adihack/esp32-swd/docs/images/board_3d_bottom.png

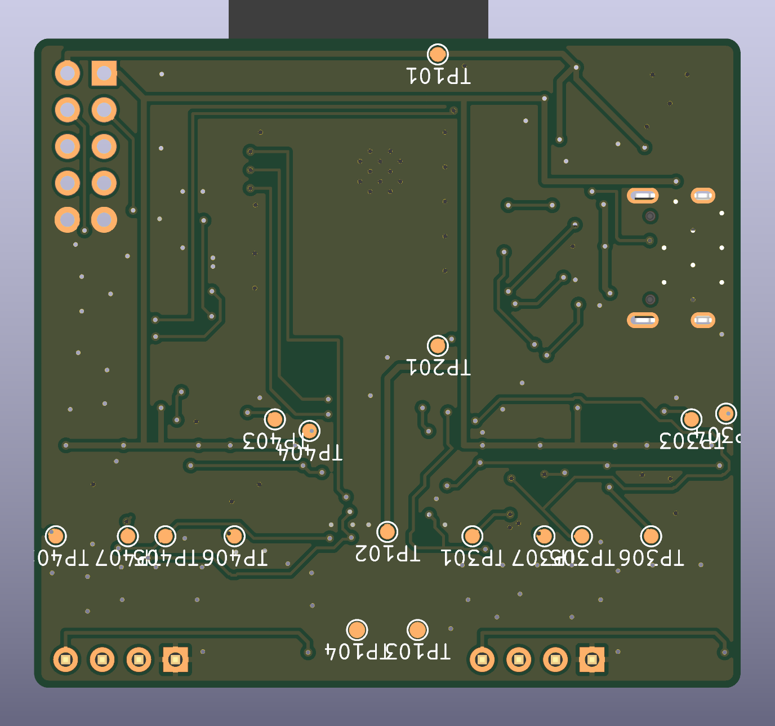
docs/images/board_3d_bottom.png
