adihack/esp32-swd/docs/images/board_3d_top.png

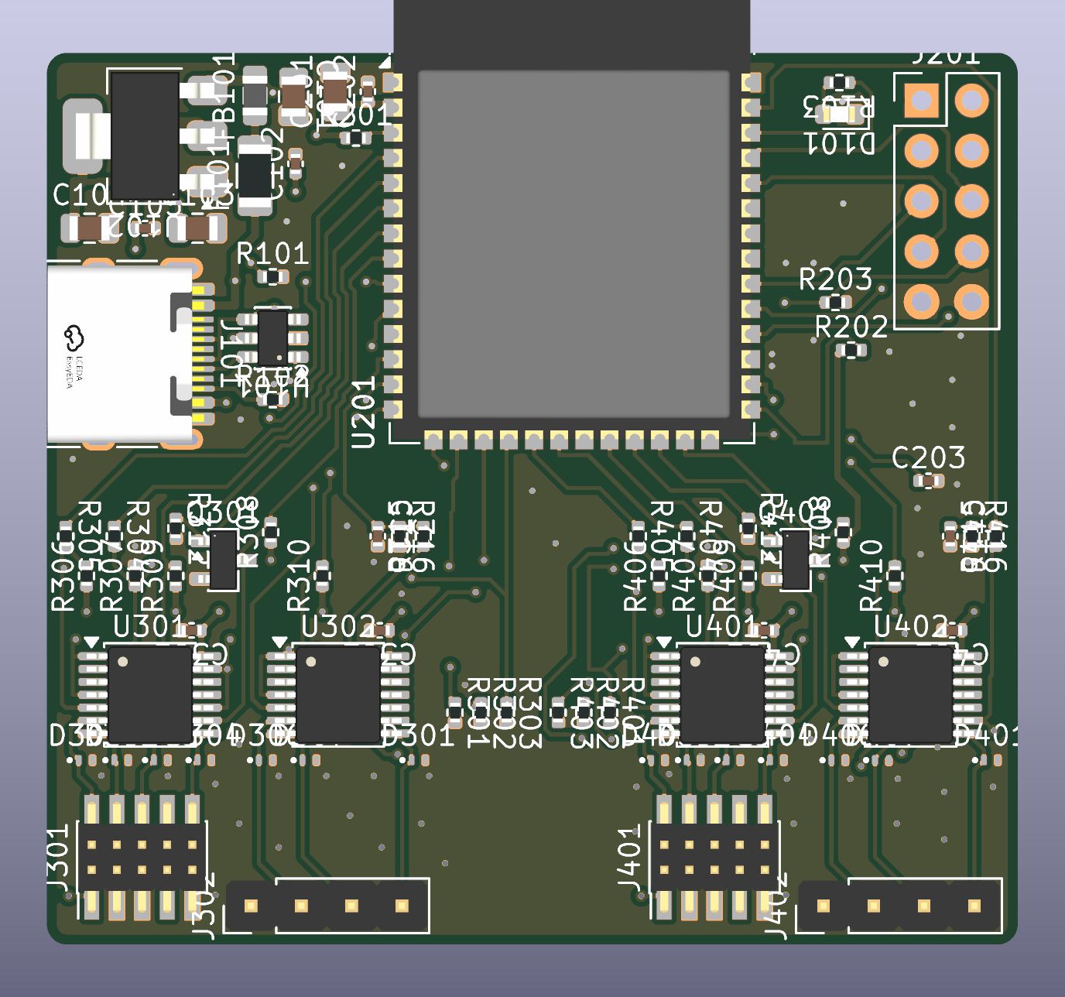
docs/images/board_3d_top.png
