adihack/esp32-swd/hardware/rev5/production/jlcpcb_2026-10-23_r5/BOM-dual_swd_flasher_JLCPCB.csv

Comment | Designator | Footprint | LCSC Part #
10uF | C101,C103,C201 | Capacitor_SMD:C_0805_2012Metric | C15850
100nF | C102,C105,C202,C301,C302,C316,C401,C402,C416 | Capacitor_SMD:C_0402_1005Metric | C1525
22uF | C104 | Capacitor_SMD:C_0805_2012Metric | C45783
1uF | C203 | Capacitor_SMD:C_0402_1005Metric | C52923
White | D101 | LED_SMD:LED_0603_1608Metric | C2290
ESD321DPYR | D301,D302,D303,D304,D305,D306,D307,D401,D402,D403,D404,D405,D406,D407 | Package_SON:Texas_DPY0002A_0.6x1mm_P0.65mm | C2868952
0R | F101 | Fuse:Fuse_1206_3216Metric | C17888
100R@100MHz | FB101 | Inductor_SMD:L_0805_2012Metric | C1015
USB_C_Receptacle_USB2.0_16P | J101 | Connector_USB:USB_C_Receptacle_HRO_TYPE-C-31-M-12 | C165948
SWD_A/SWD_B | J301,J401 | Connector_PinHeader_1.27mm:PinHeader_2x05_P1.27mm_Vertical_SMD | C3975188
2N7002 | Q301,Q401 | Package_TO_SOT_SMD:SOT-23 | C8545
5.1k | R101,R102 | Resistor_SMD:R_0402_1005Metric | C25905
1k | R103 | Resistor_SMD:R_0402_1005Metric | C11702
10k | R201,R202,R203 | Resistor_SMD:R_0402_1005Metric | C25744
100k | R301,R302,R303,R306,R307,R308,R309,R310,R312,R315,R316,R401,R402,R403,R406,R407,R408,R409,R410,R412,R415,R416 | Resistor_SMD:R_0402_1005Metric | C25741
33R | R304,R305,R404,R405 | Resistor_SMD:R_0402_1005Metric | C25105
SRV05-4 | U101 | Package_TO_SOT_SMD:SOT-23-6 | C7420376
AMS1117-3.3 | U102 | Package_TO_SOT_SMD:SOT-223-3_TabPin2 | C6186
TMUX1511PW | U301,U302,U401,U402 | Package_SO:TSSOP-14_4.4x5mm_P0.65mm | C2866750
