adihack/esp32-swd/hardware/rev5/schematic_rev5.pdf

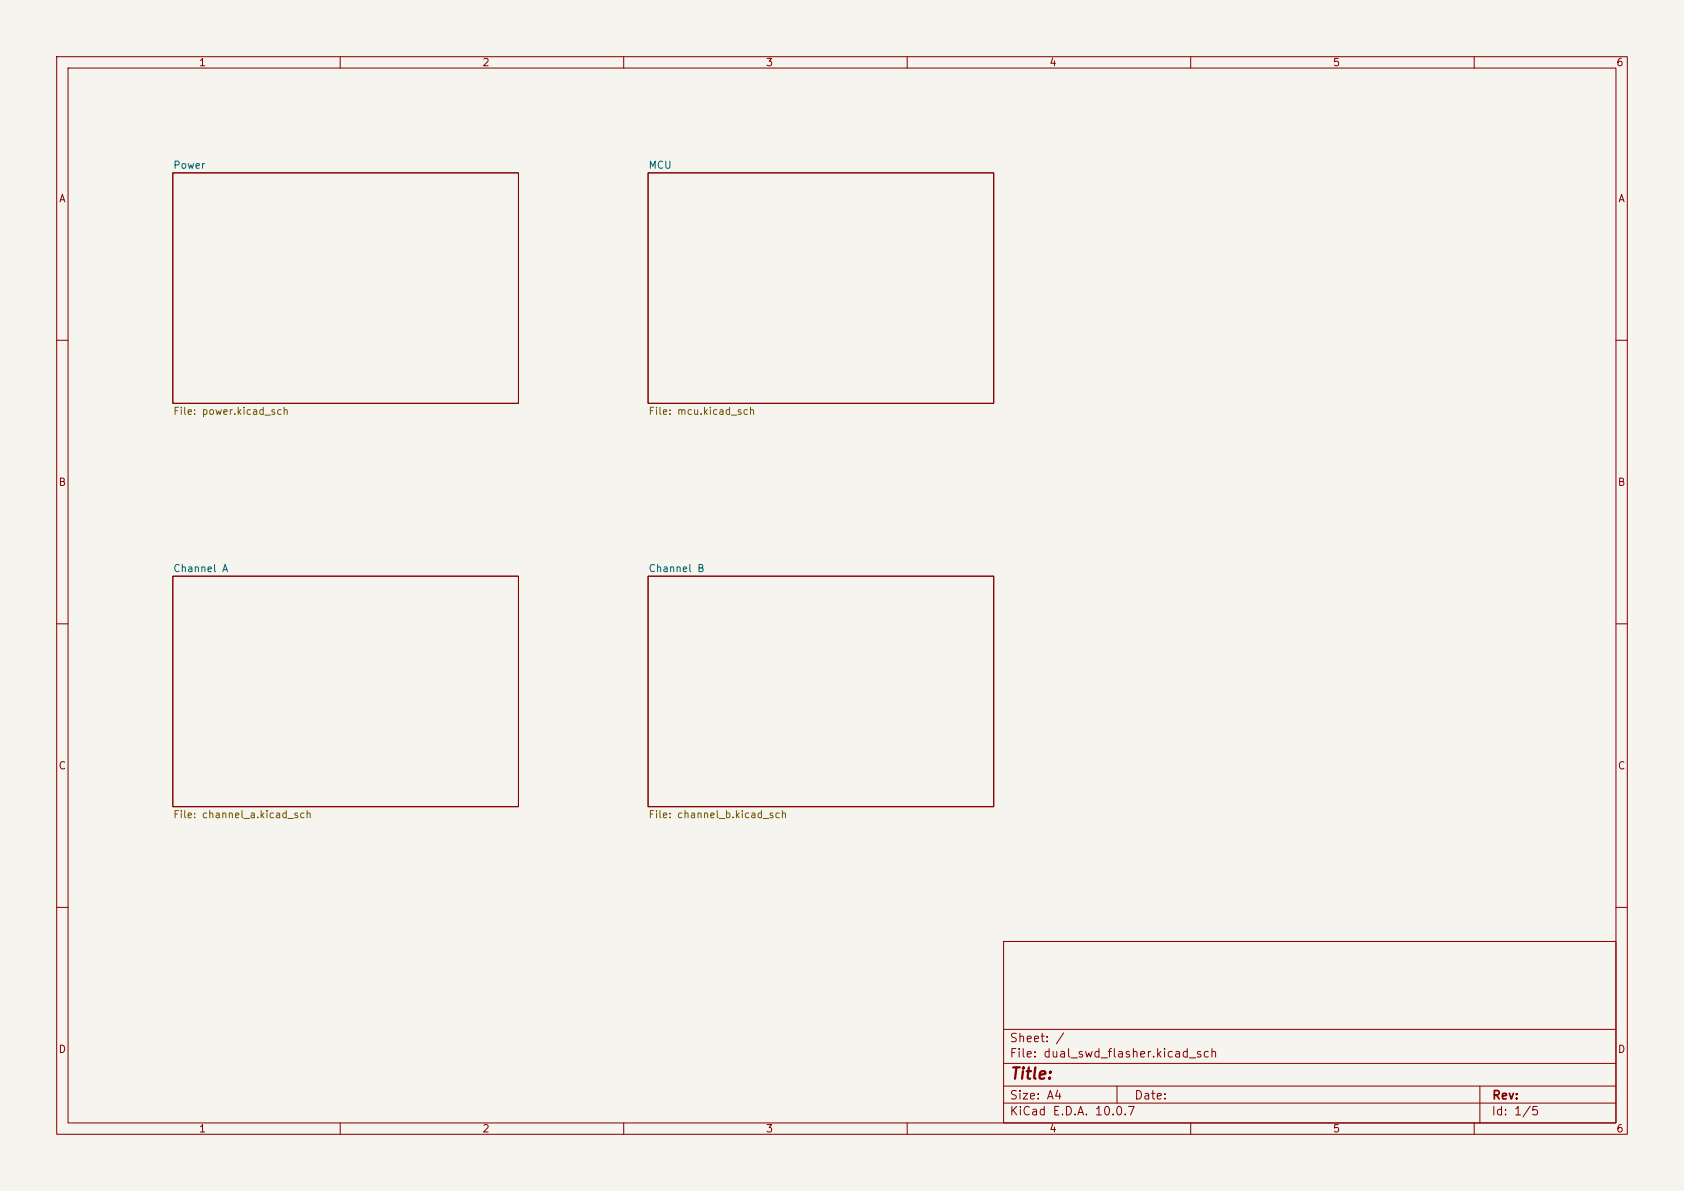
[picture p4: page 1]

Size: A4 | Rev:
KiCad E.D.A. 10.0.7 | Id: 1/5

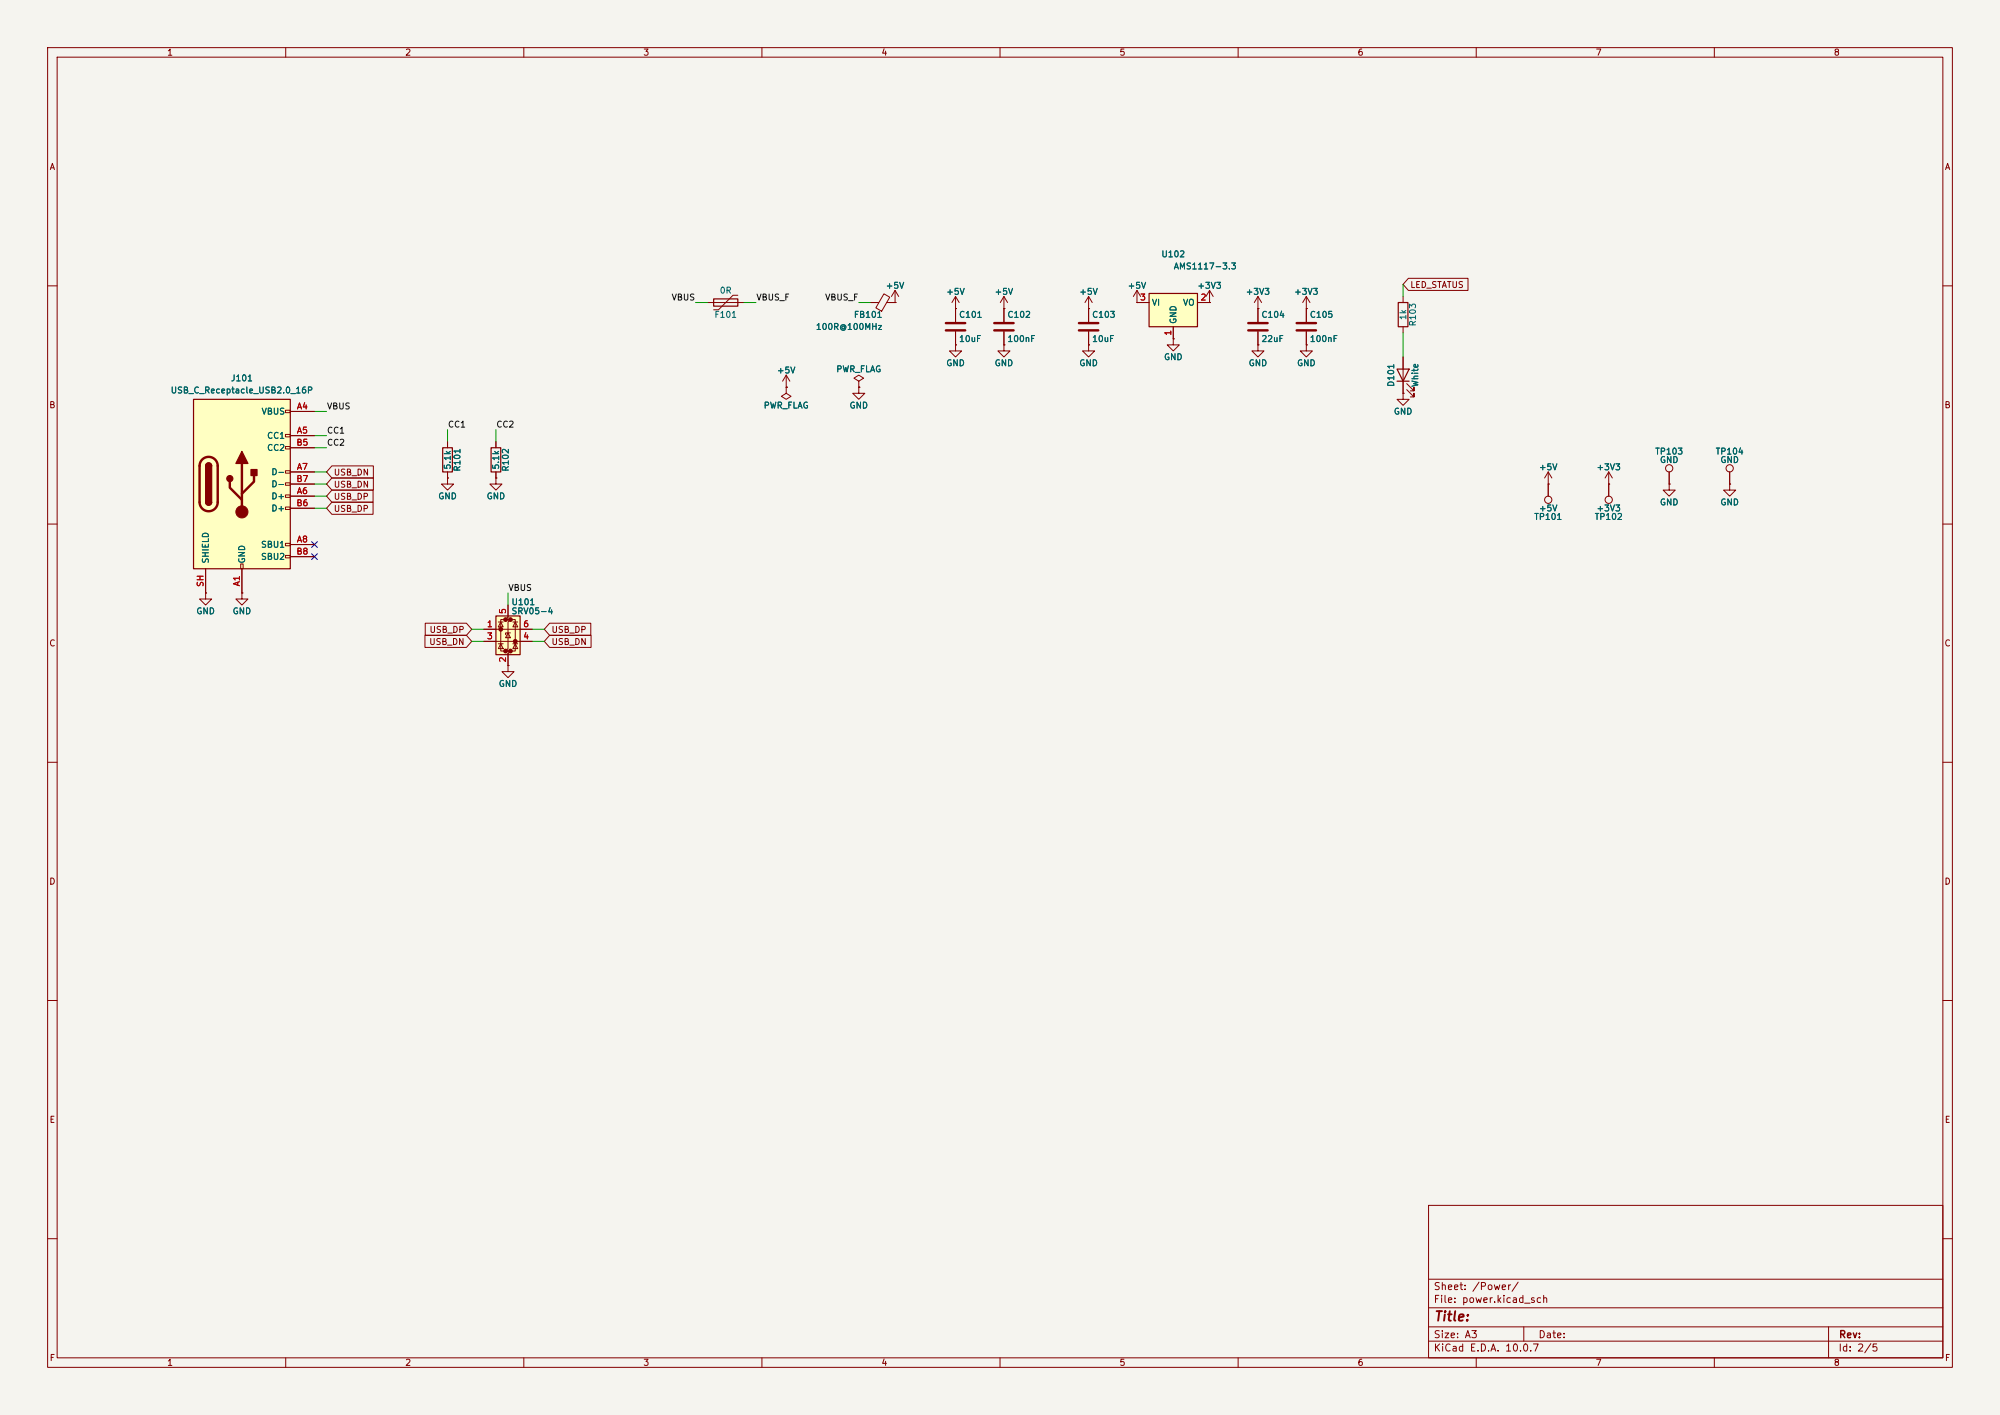
[picture p5: page 2]

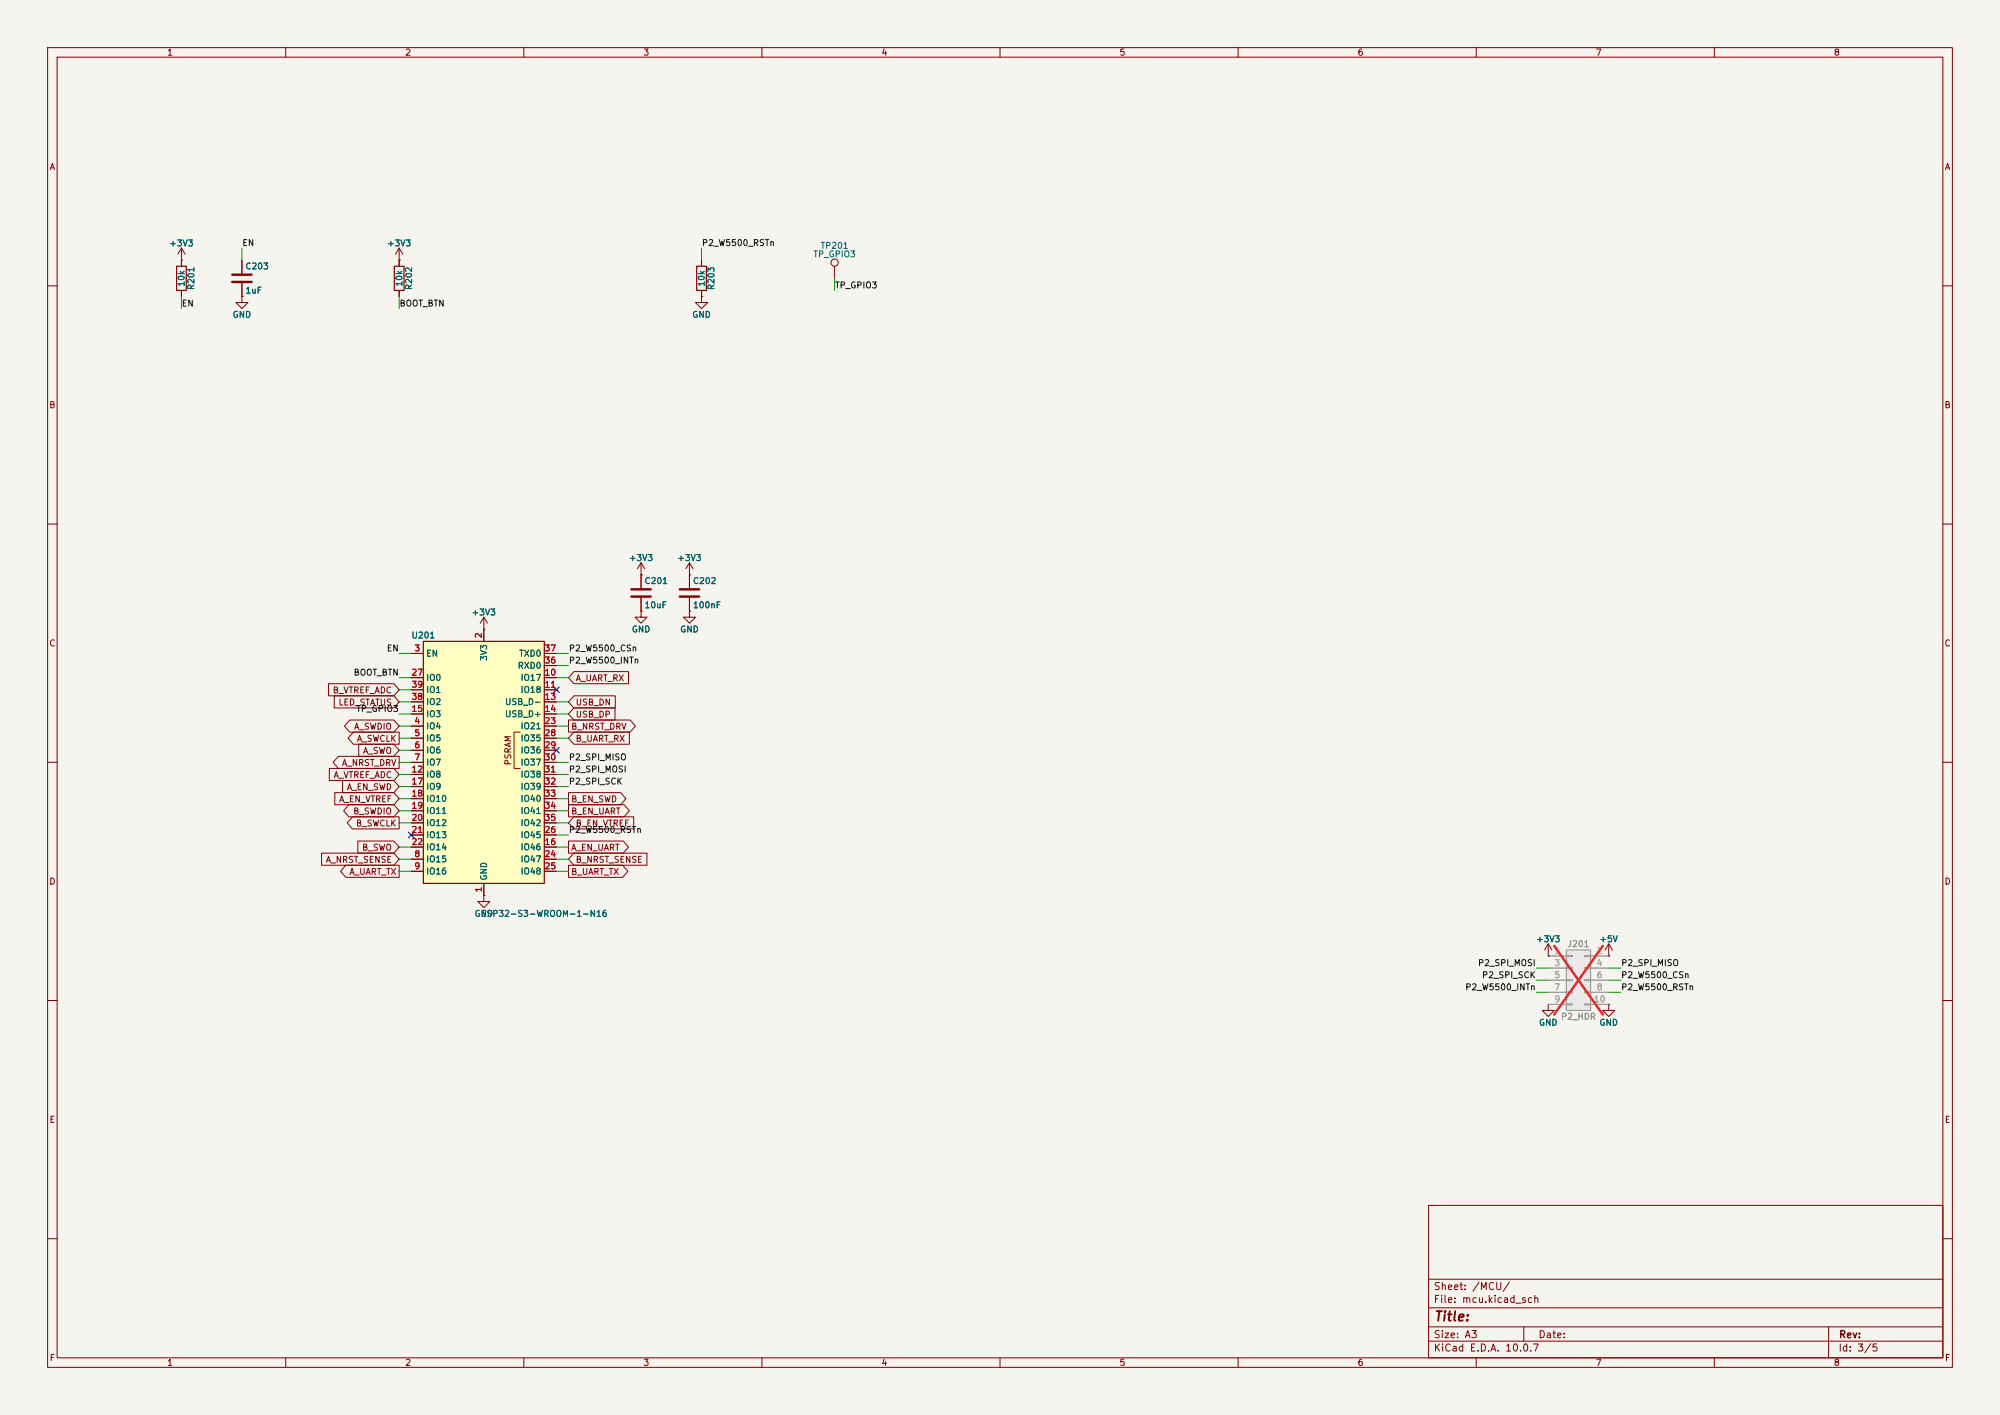
[picture p6: page 3]

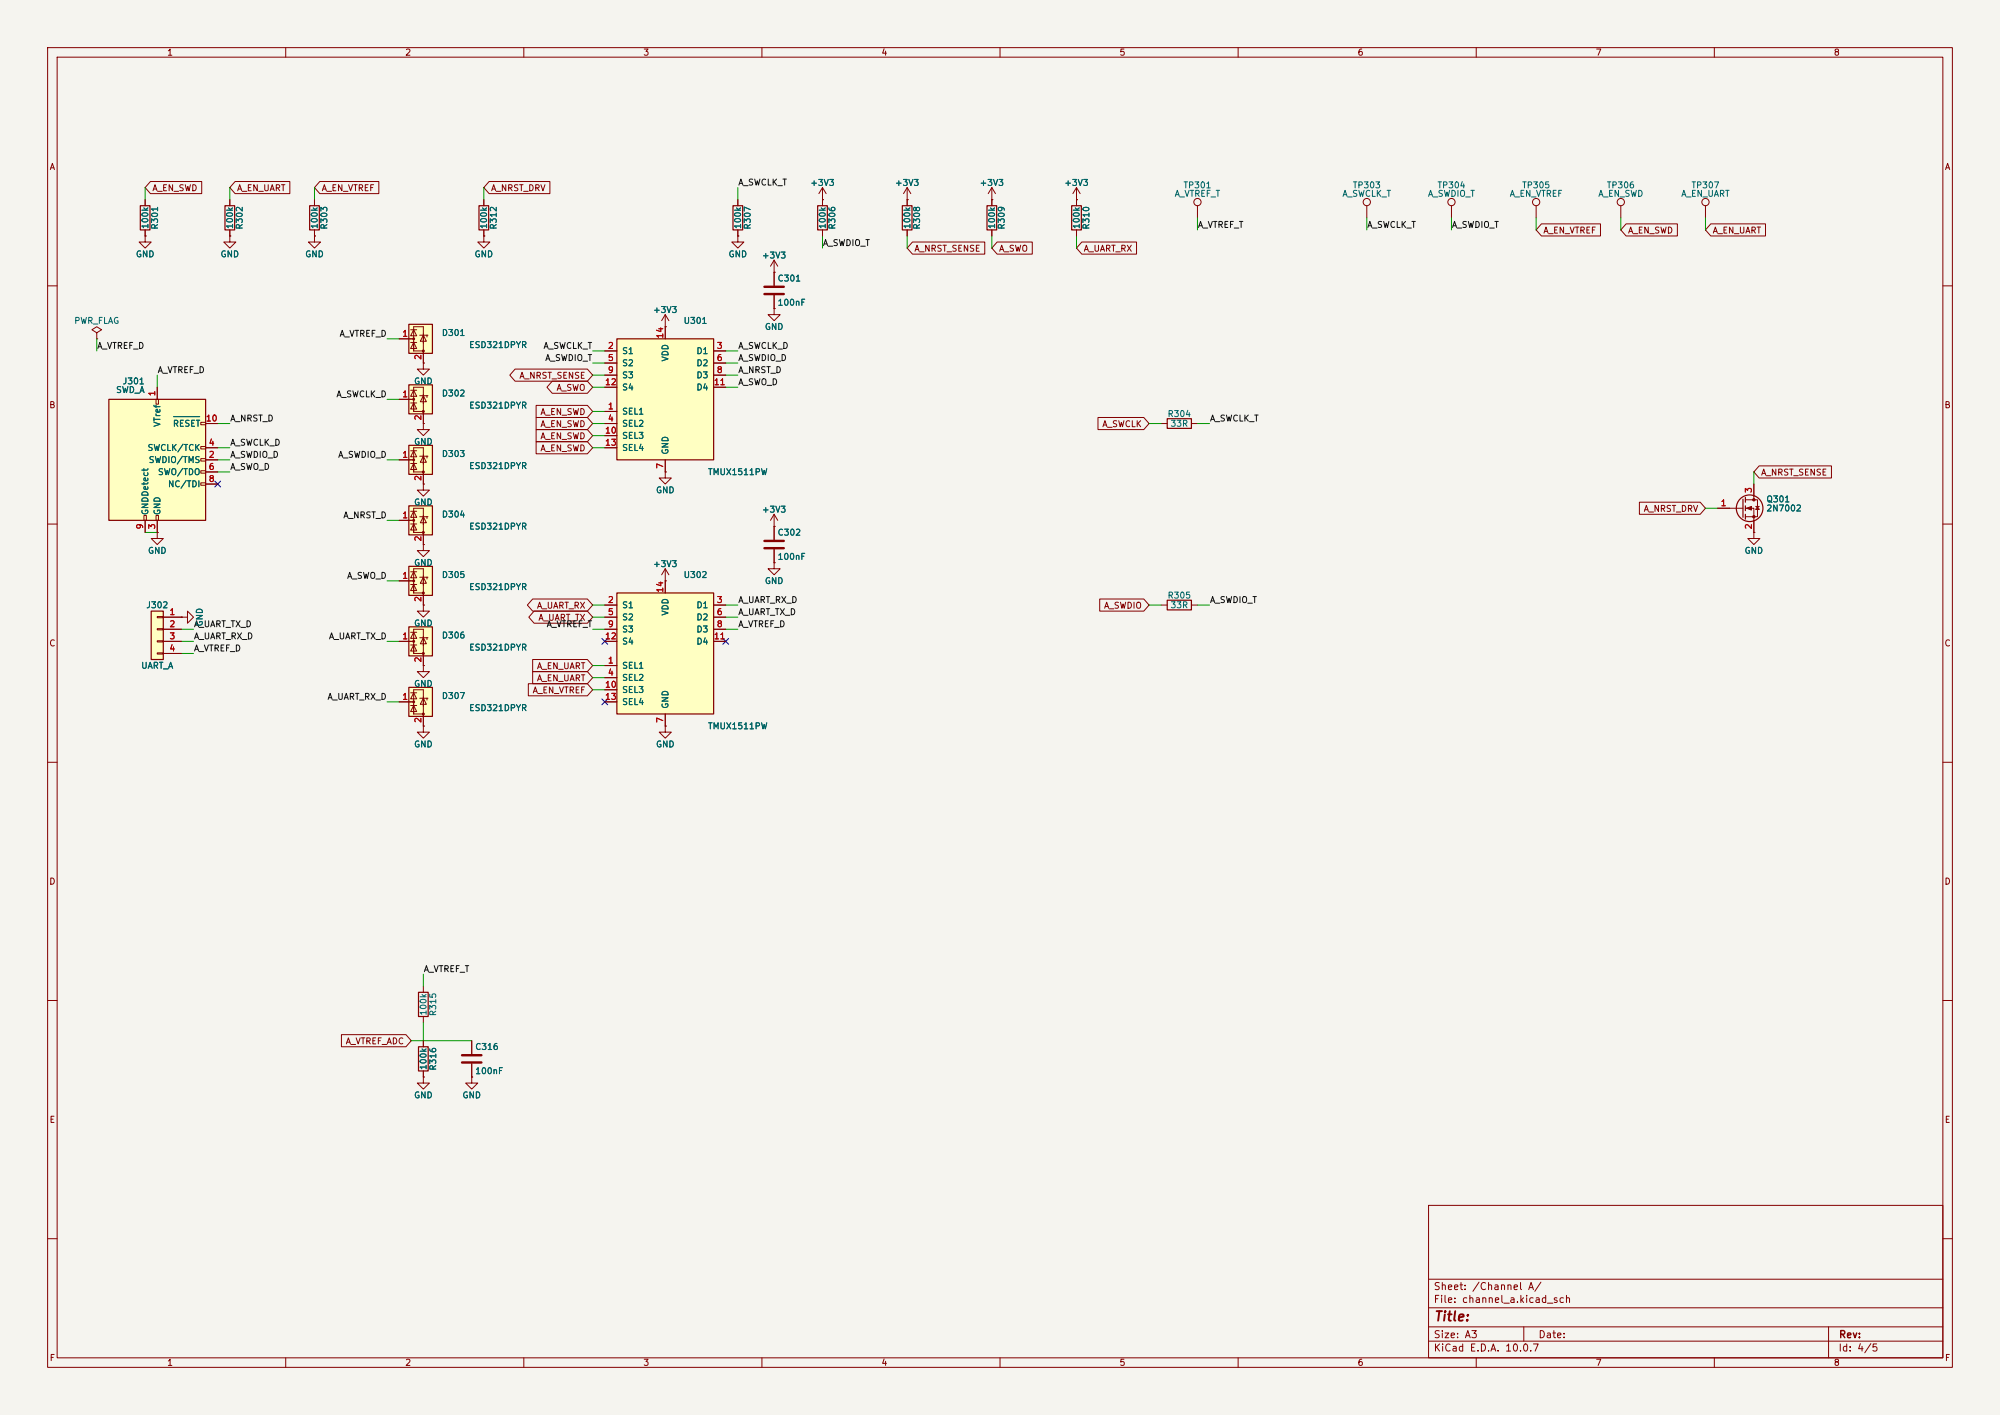
[picture p7: page 4]

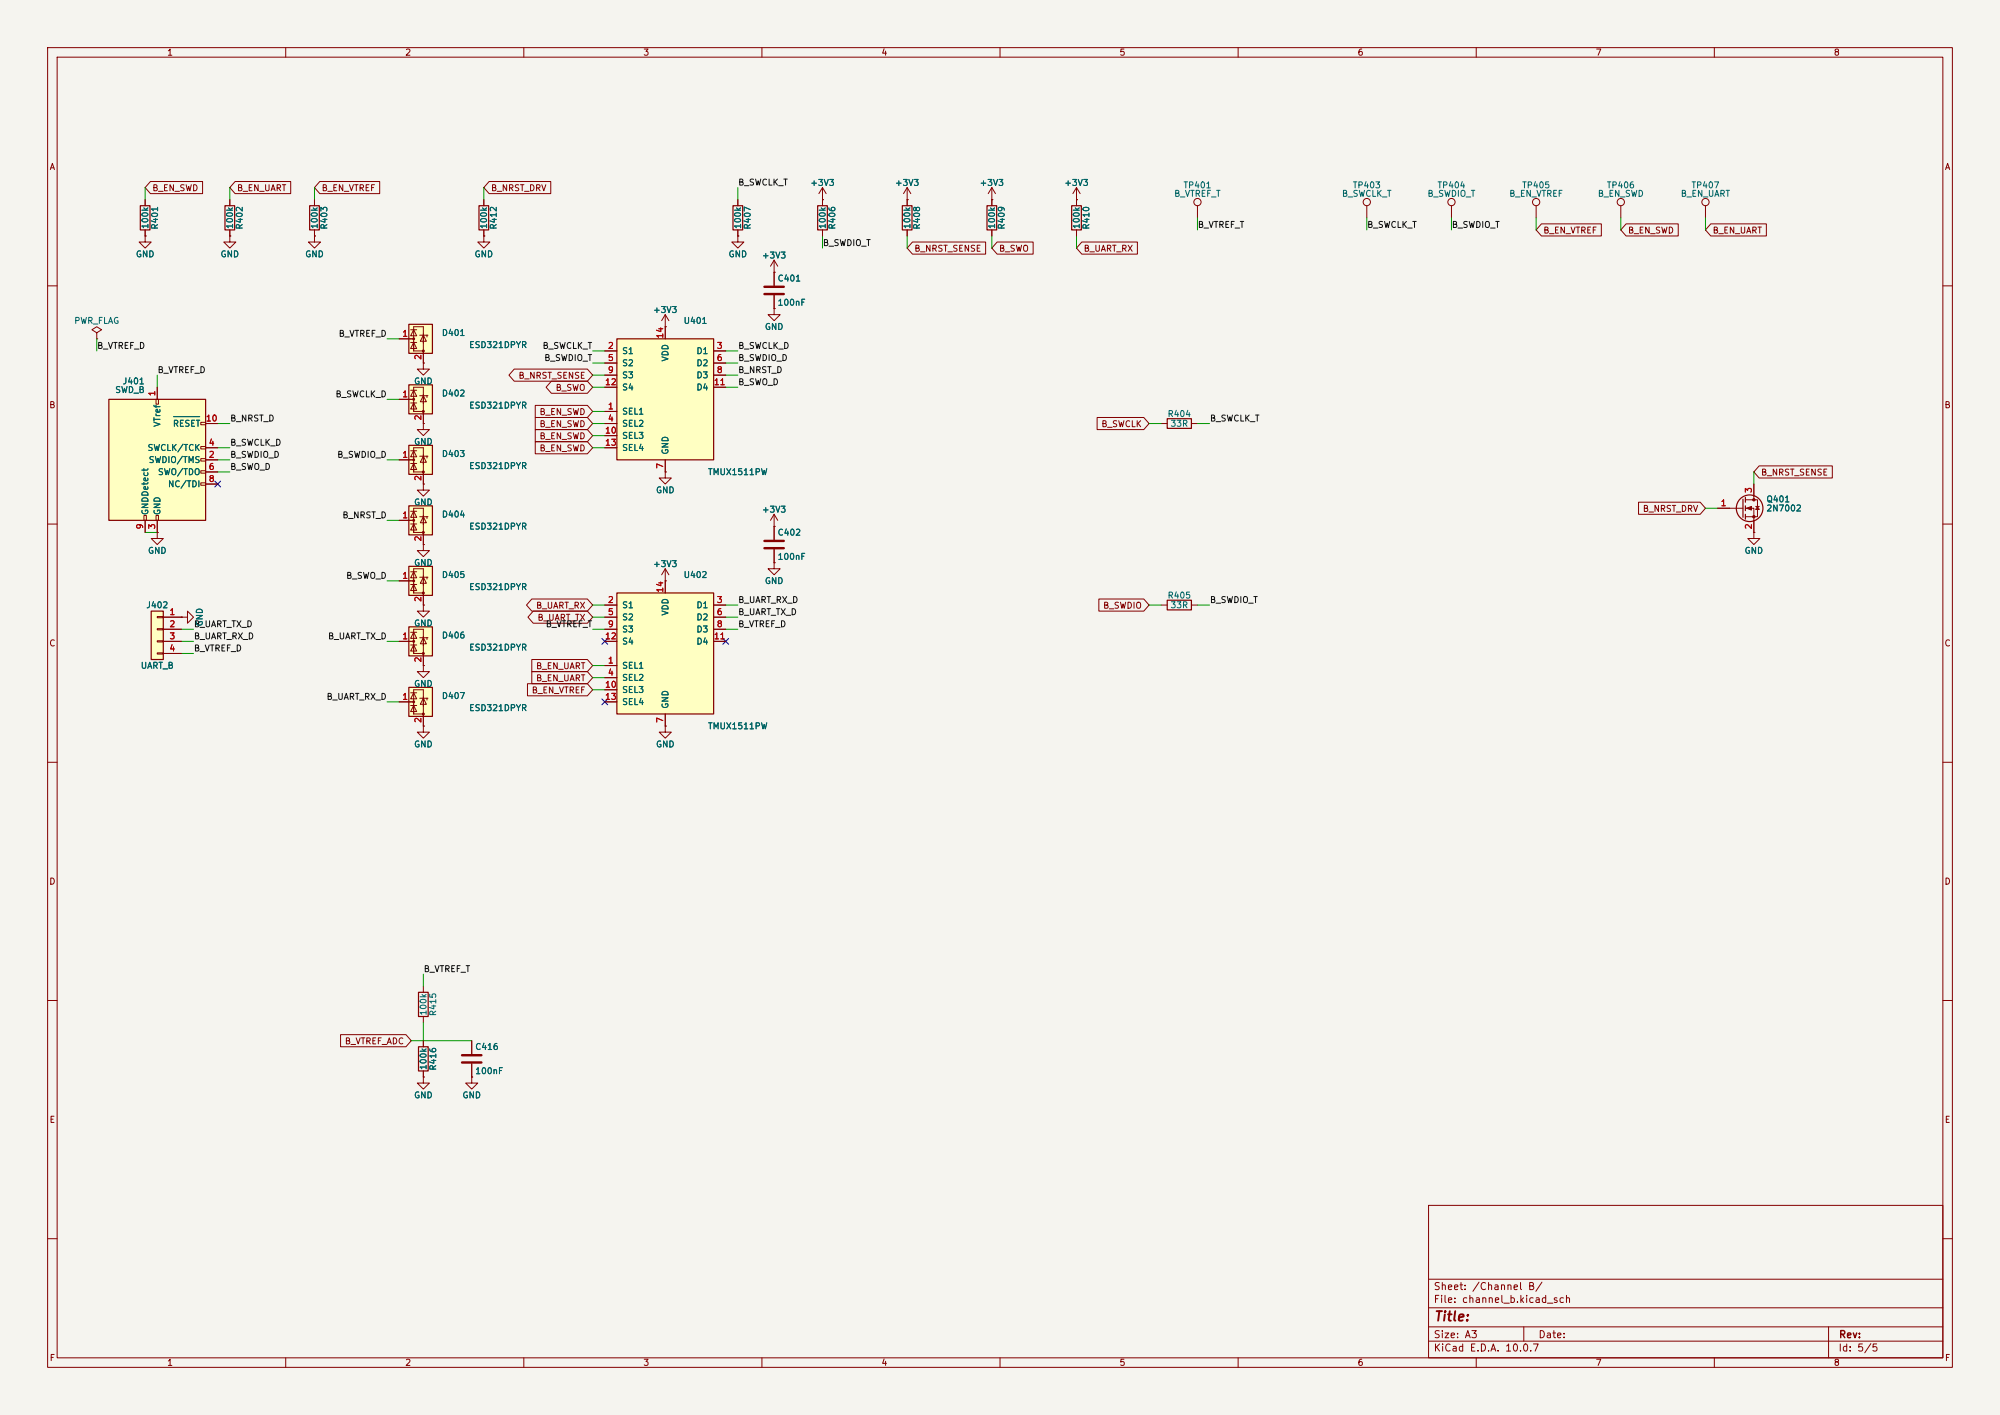
[picture p8: page 5]
