adihack/esp32-swd/hardware/rev5/kicad/dual_swd_flasher.kicad_pcb

## KiCad design hardware/rev5/kicad/dual_swd_flasher.kicad_pcb (2026-11-08)

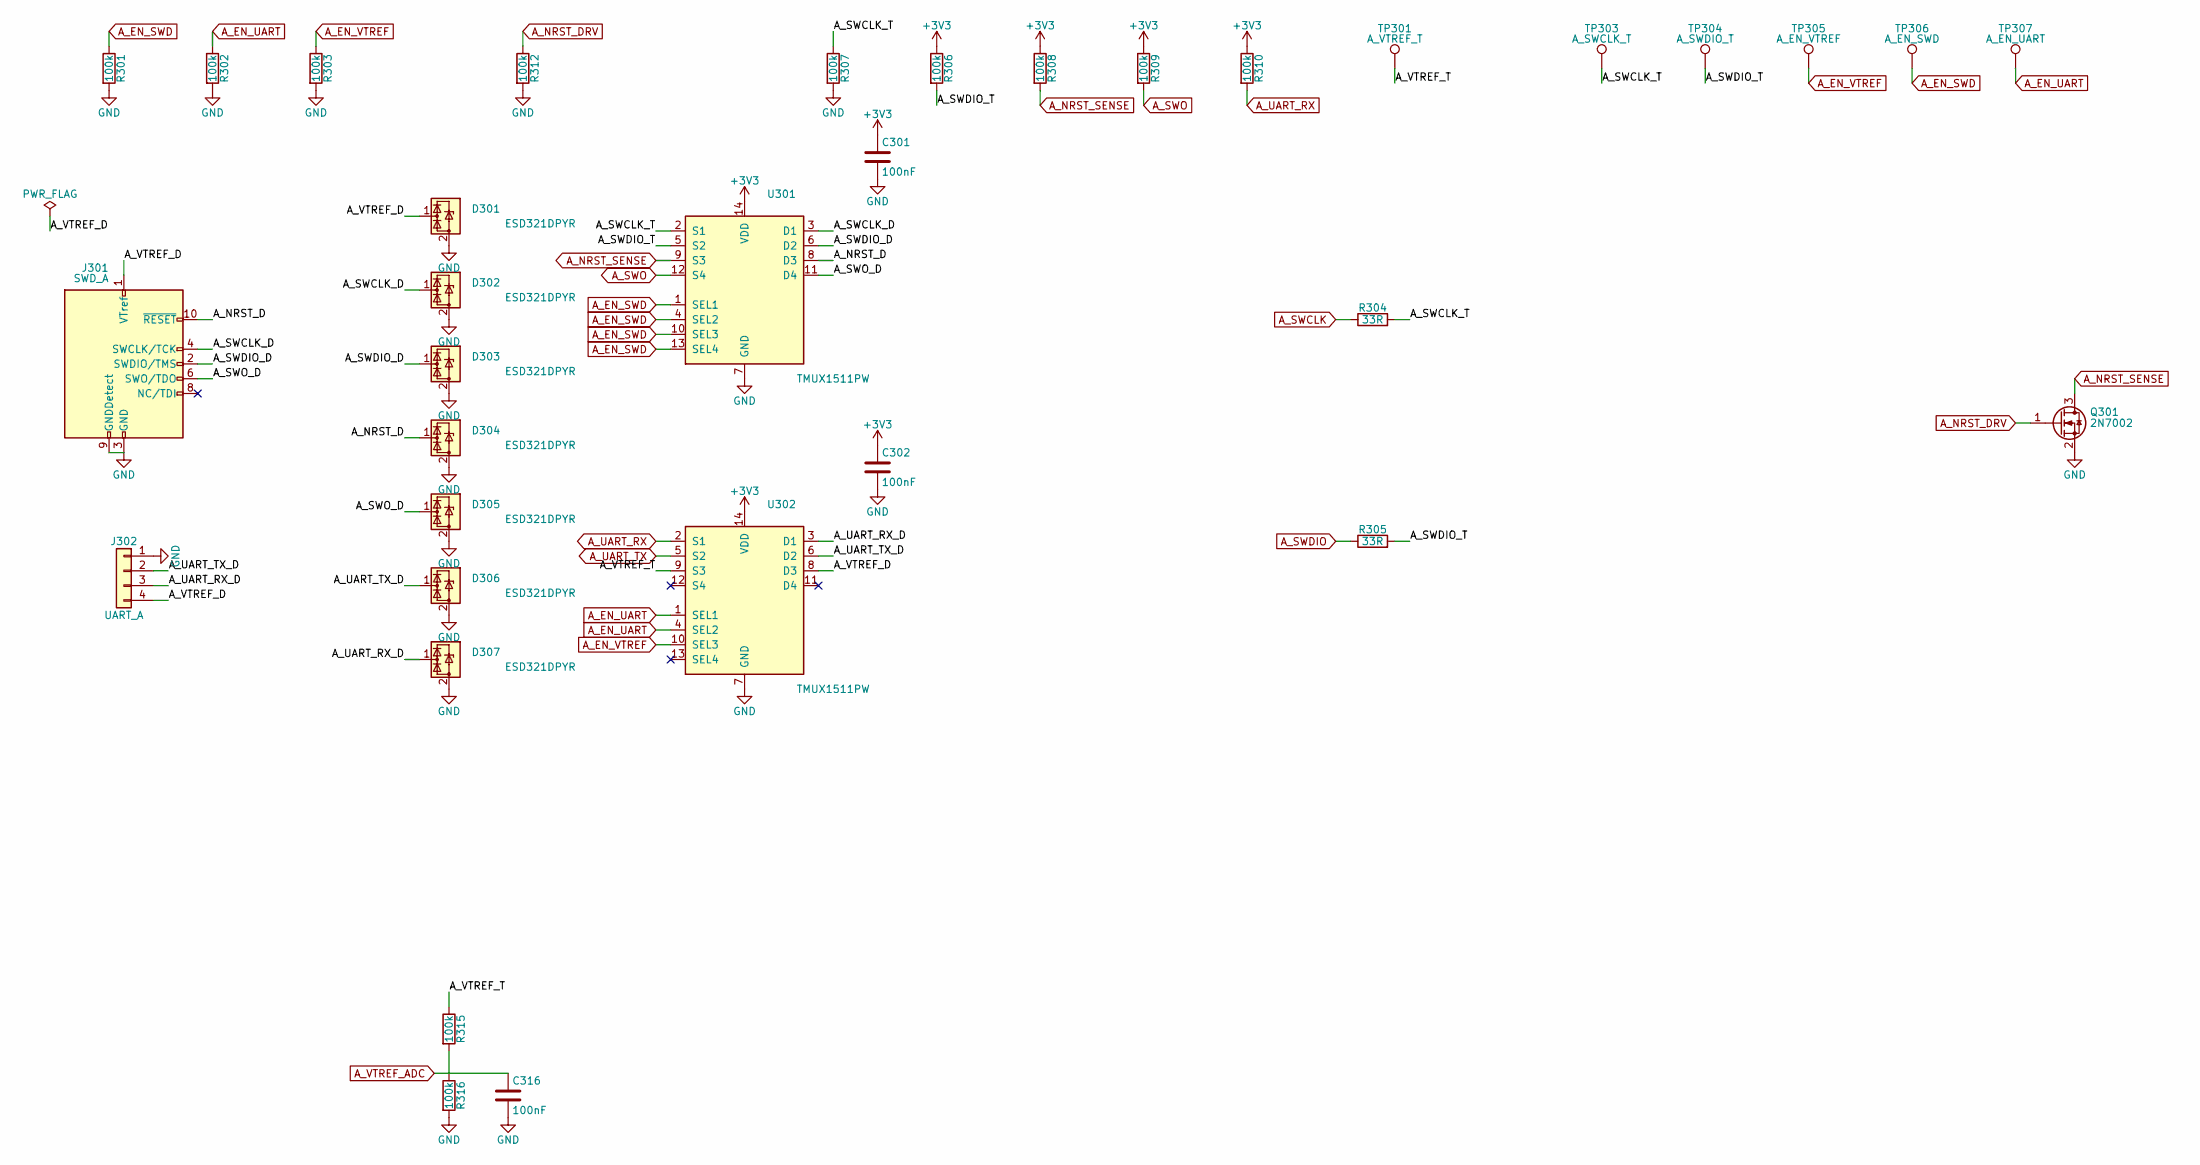
[picture p9: schematic channel_a.kicad_sch]

Parts:
C301, C302, C316: 100nF; C_0402_1005Metric; LCSC C1525
D301, D302, D303, D304, D305, D306, D307: ESD321DPYR; Texas_DPY0002A_0.6x1mm_P0.65mm; LCSC C2868952
J301: SWD_A; PinHeader_2x05_P1.27mm_Vertical_SMD; LCSC C3975188
J302: UART_A; PinHeader_1x04_P2.54mm_Vertical; LCSC C2691448
Q301: 2N7002; SOT-23; LCSC C8545
R301, R302, R303, R306, R307, R308, R309, R310, R312, R315, R316: 100k; R_0402_1005Metric; LCSC C25741
R304, R305: 33R; R_0402_1005Metric; LCSC C25105
TP301: A_VTREF_T; TestPoint_Pad_D1.0mm
TP303: A_SWCLK_T; TestPoint_Pad_D1.0mm
TP304: A_SWDIO_T; TestPoint_Pad_D1.0mm
TP305: A_EN_VTREF; TestPoint_Pad_D1.0mm
TP306: A_EN_SWD; TestPoint_Pad_D1.0mm
TP307: A_EN_UART; TestPoint_Pad_D1.0mm
U301, U302: TMUX1511PW; TSSOP-14_4.4x5mm_P0.65mm; LCSC C2866750

Connections:
+3V3: C301.1, C302.1, R306.1, R308.1, R309.1, R310.1, U301.14 (VDD), U302.14 (VDD); also elsewhere on the board
/Channel A/A_NRST_D: D304.1 (I/O), J301.10 (~RESET), U301.8 (D3)
/Channel A/A_SWCLK_D: D302.1 (I/O), J301.4 (SWCLK/TCK), U301.3 (D1)
/Channel A/A_SWCLK_T: R304.2, R307.1, TP303.1 (1_1), U301.2 (S1)
/Channel A/A_SWDIO_D: D303.1 (I/O), J301.2 (SWDIO/TMS), U301.6 (D2)
/Channel A/A_SWDIO_T: R305.2, R306.2, TP304.1 (1_1), U301.5 (S2)
/Channel A/A_SWO_D: D305.1 (I/O), J301.6 (SWO/TDO), U301.11 (D4)
/Channel A/A_UART_RX_D: D307.1 (I/O), J302.3, U302.3 (D1)
/Channel A/A_UART_TX_D: D306.1 (I/O), J302.2, U302.6 (D2)
/Channel A/A_VTREF_D: D301.1 (I/O), J301.1 (VTref), J302.4, U302.8 (D3)
/Channel A/A_VTREF_T: R315.1, TP301.1 (1_1), U302.9 (S3)
A_EN_SWD: R301.1, TP306.1 (1_1), U301.1 (SEL1), U301.4 (SEL2), U301.10 (SEL3), U301.13 (SEL4); also elsewhere on the board
A_EN_UART: R302.1, TP307.1 (1_1), U302.1 (SEL1), U302.4 (SEL2); also elsewhere on the board
A_EN_VTREF: R303.1, TP305.1 (1_1), U302.10 (SEL3); also elsewhere on the board
A_NRST_DRV: Q301.1 (G), R312.1; also elsewhere on the board
A_NRST_SENSE: Q301.3 (D), R308.2, U301.9 (S3); also elsewhere on the board
A_SWCLK: R304.1; also elsewhere on the board
A_SWDIO: R305.1; also elsewhere on the board
A_SWO: R309.2, U301.12 (S4); also elsewhere on the board
A_UART_RX: R310.2, U302.2 (S1); also elsewhere on the board
A_UART_TX: U302.5 (S2); also elsewhere on the board
A_VTREF_ADC: C316.1, R315.2, R316.1; also elsewhere on the board
GND: C301.2, C302.2, C316.2, D301.2 (GND), D302.2 (GND), D303.2 (GND), D304.2 (GND), D305.2 (GND), D306.2 (GND), D307.2 (GND), J301.3 (GND), J301.5 (GND), J301.9 (GNDDetect), J302.1, Q301.2 (S), R301.2, R302.2, R303.2, R307.2, R312.2, R316.2, U301.7 (GND), U302.7 (GND); also elsewhere on the board

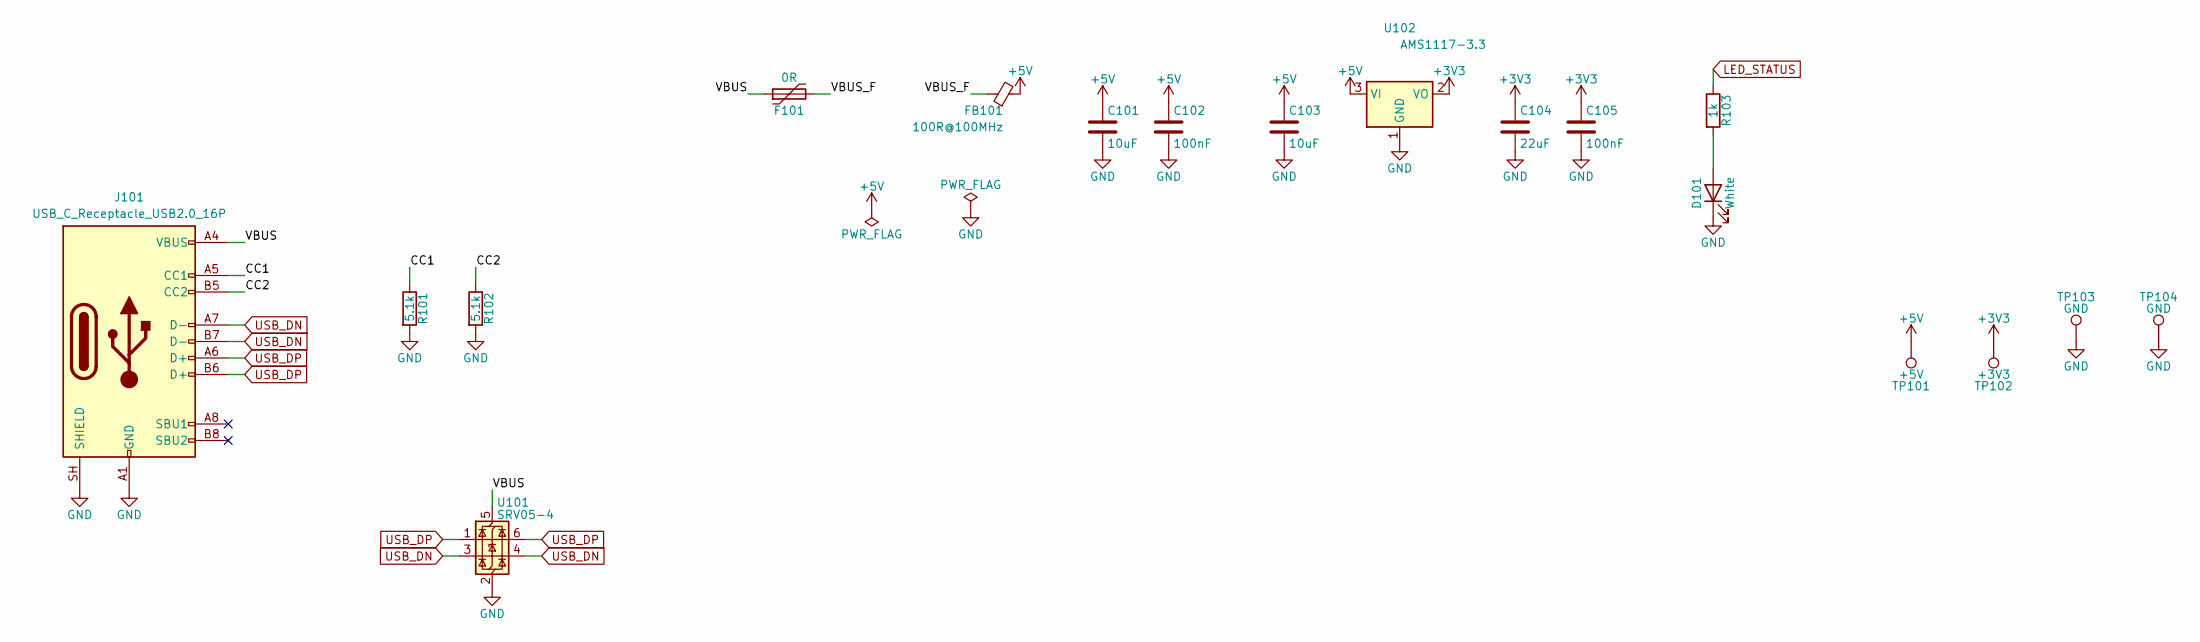
[picture p10: schematic power.kicad_sch]

Parts:
C101, C103: 10uF; C_0805_2012Metric; LCSC C15850
C102, C105: 100nF; C_0402_1005Metric; LCSC C1525
C104: 22uF; C_0805_2012Metric; LCSC C45783
D101: White; LED_0603_1608Metric; LCSC C2290
F101: 0R; Fuse_1206_3216Metric; LCSC C17888
FB101: 100R@100MHz; L_0805_2012Metric; LCSC C1015
J101: USB_C_Receptacle_USB2.0_16P; USB_C_Receptacle_HRO_TYPE-C-31-M-12; LCSC C165948
R101, R102: 5.1k; R_0402_1005Metric; LCSC C25905
R103: 1k; R_0402_1005Metric; LCSC C11702
TP101: +5V; TestPoint_Pad_D1.0mm
TP102: +3V3; TestPoint_Pad_D1.0mm
TP103, TP104: GND; TestPoint_Pad_D1.0mm
U101: SRV05-4; SOT-23-6; LCSC C7420376
U102: AMS1117-3.3; SOT-223-3_TabPin2; LCSC C6186

Connections:
+3V3: C104.1, C105.1, TP102.1 (1_1), U102.2 (VO); also elsewhere on the board
+5V: C101.1, C102.1, C103.1, FB101.2, TP101.1 (1_1), U102.3 (VI); also elsewhere on the board
/Power/CC1: J101.A5 (CC1), R101.1
/Power/CC2: J101.B5 (CC2), R102.1
/Power/VBUS: F101.1, J101.A4 (VBUS), J101.A9 (VBUS), J101.B4 (VBUS), J101.B9 (VBUS), U101.5 (VBUS)
/Power/VBUS_F: F101.2, FB101.1
GND: C101.2, C102.2, C103.2, C104.2, C105.2, D101.1 (K), J101.A1 (GND), J101.A12 (GND), J101.B1 (GND), J101.B12 (GND), J101.SH (SHIELD), R101.2, R102.2, TP103.1 (1_1), TP104.1 (1_1), U101.2 (GND), U102.1 (GND); also elsewhere on the board
LED_STATUS: R103.1; also elsewhere on the board
unnamed: D101.2 (A), R103.2
USB_DN: J101.A7 (D-), J101.B7 (D-), U101.3 (I/O2), U101.4 (I/O2); also elsewhere on the board
USB_DP: J101.A6 (D+), J101.B6 (D+), U101.1 (I/O1), U101.6 (I/O1); also elsewhere on the board

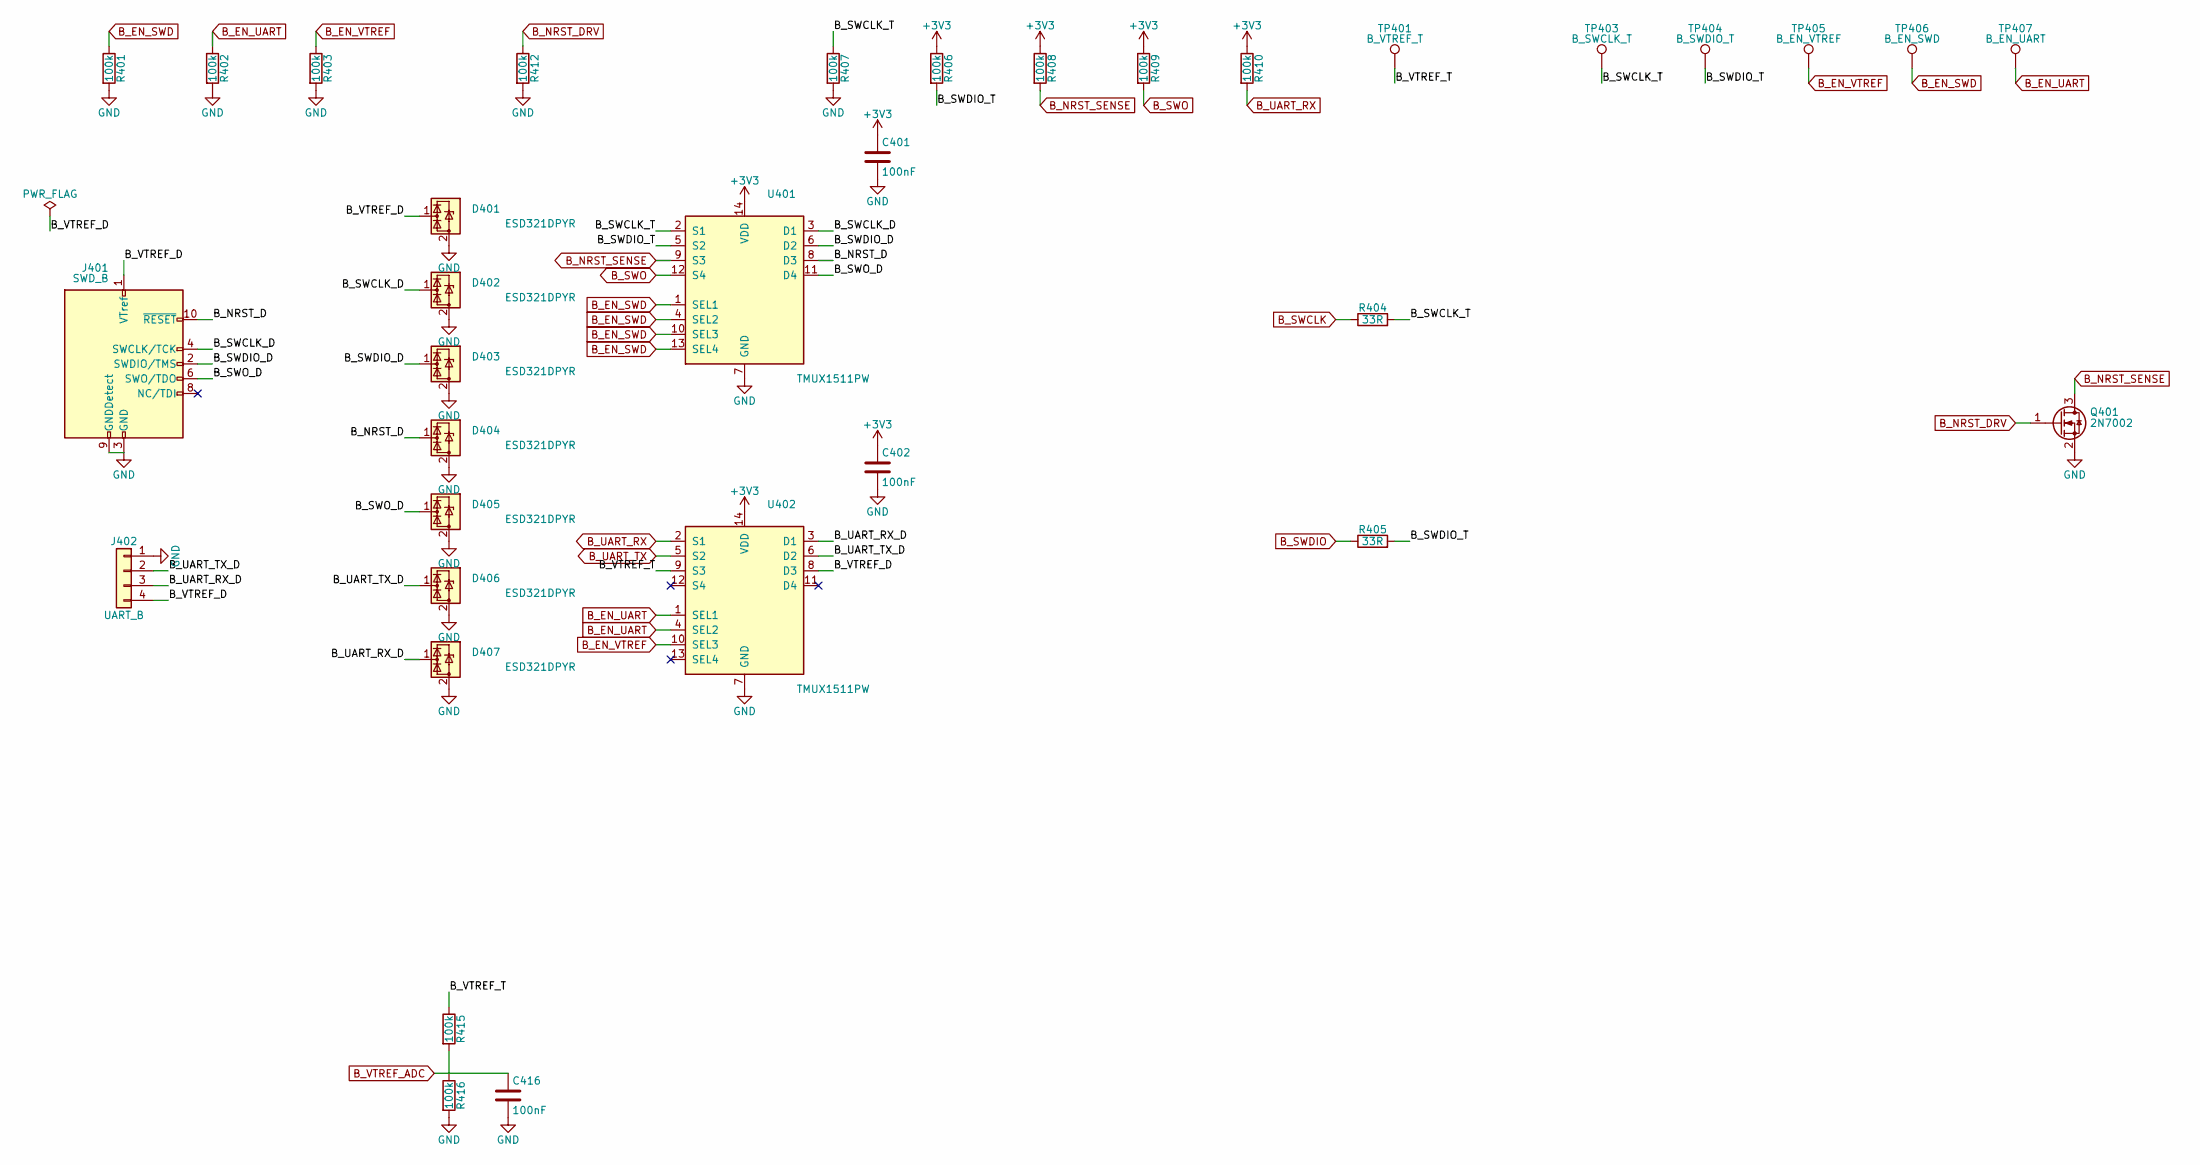
[picture p11: schematic channel_b.kicad_sch]

Parts:
C401, C402, C416: 100nF; C_0402_1005Metric; LCSC C1525
D401, D402, D403, D404, D405, D406, D407: ESD321DPYR; Texas_DPY0002A_0.6x1mm_P0.65mm; LCSC C2868952
J401: SWD_B; PinHeader_2x05_P1.27mm_Vertical_SMD; LCSC C3975188
J402: UART_B; PinHeader_1x04_P2.54mm_Vertical; LCSC C2691448
Q401: 2N7002; SOT-23; LCSC C8545
R401, R402, R403, R406, R407, R408, R409, R410, R412, R415, R416: 100k; R_0402_1005Metric; LCSC C25741
R404, R405: 33R; R_0402_1005Metric; LCSC C25105
TP401: B_VTREF_T; TestPoint_Pad_D1.0mm
TP403: B_SWCLK_T; TestPoint_Pad_D1.0mm
TP404: B_SWDIO_T; TestPoint_Pad_D1.0mm
TP405: B_EN_VTREF; TestPoint_Pad_D1.0mm
TP406: B_EN_SWD; TestPoint_Pad_D1.0mm
TP407: B_EN_UART; TestPoint_Pad_D1.0mm
U401, U402: TMUX1511PW; TSSOP-14_4.4x5mm_P0.65mm; LCSC C2866750

Connections:
+3V3: C401.1, C402.1, R406.1, R408.1, R409.1, R410.1, U401.14 (VDD), U402.14 (VDD); also elsewhere on the board
/Channel B/B_NRST_D: D404.1 (I/O), J401.10 (~RESET), U401.8 (D3)
/Channel B/B_SWCLK_D: D402.1 (I/O), J401.4 (SWCLK/TCK), U401.3 (D1)
/Channel B/B_SWCLK_T: R404.2, R407.1, TP403.1 (1_1), U401.2 (S1)
/Channel B/B_SWDIO_D: D403.1 (I/O), J401.2 (SWDIO/TMS), U401.6 (D2)
/Channel B/B_SWDIO_T: R405.2, R406.2, TP404.1 (1_1), U401.5 (S2)
/Channel B/B_SWO_D: D405.1 (I/O), J401.6 (SWO/TDO), U401.11 (D4)
/Channel B/B_UART_RX_D: D407.1 (I/O), J402.3, U402.3 (D1)
/Channel B/B_UART_TX_D: D406.1 (I/O), J402.2, U402.6 (D2)
/Channel B/B_VTREF_D: D401.1 (I/O), J401.1 (VTref), J402.4, U402.8 (D3)
/Channel B/B_VTREF_T: R415.1, TP401.1 (1_1), U402.9 (S3)
B_EN_SWD: R401.1, TP406.1 (1_1), U401.1 (SEL1), U401.4 (SEL2), U401.10 (SEL3), U401.13 (SEL4); also elsewhere on the board
B_EN_UART: R402.1, TP407.1 (1_1), U402.1 (SEL1), U402.4 (SEL2); also elsewhere on the board
B_EN_VTREF: R403.1, TP405.1 (1_1), U402.10 (SEL3); also elsewhere on the board
B_NRST_DRV: Q401.1 (G), R412.1; also elsewhere on the board
B_NRST_SENSE: Q401.3 (D), R408.2, U401.9 (S3); also elsewhere on the board
B_SWCLK: R404.1; also elsewhere on the board
B_SWDIO: R405.1; also elsewhere on the board
B_SWO: R409.2, U401.12 (S4); also elsewhere on the board
B_UART_RX: R410.2, U402.2 (S1); also elsewhere on the board
B_UART_TX: U402.5 (S2); also elsewhere on the board
B_VTREF_ADC: C416.1, R415.2, R416.1; also elsewhere on the board
GND: C401.2, C402.2, C416.2, D401.2 (GND), D402.2 (GND), D403.2 (GND), D404.2 (GND), D405.2 (GND), D406.2 (GND), D407.2 (GND), J401.3 (GND), J401.5 (GND), J401.9 (GNDDetect), J402.1, Q401.2 (S), R401.2, R402.2, R403.2, R407.2, R412.2, R416.2, U401.7 (GND), U402.7 (GND); also elsewhere on the board

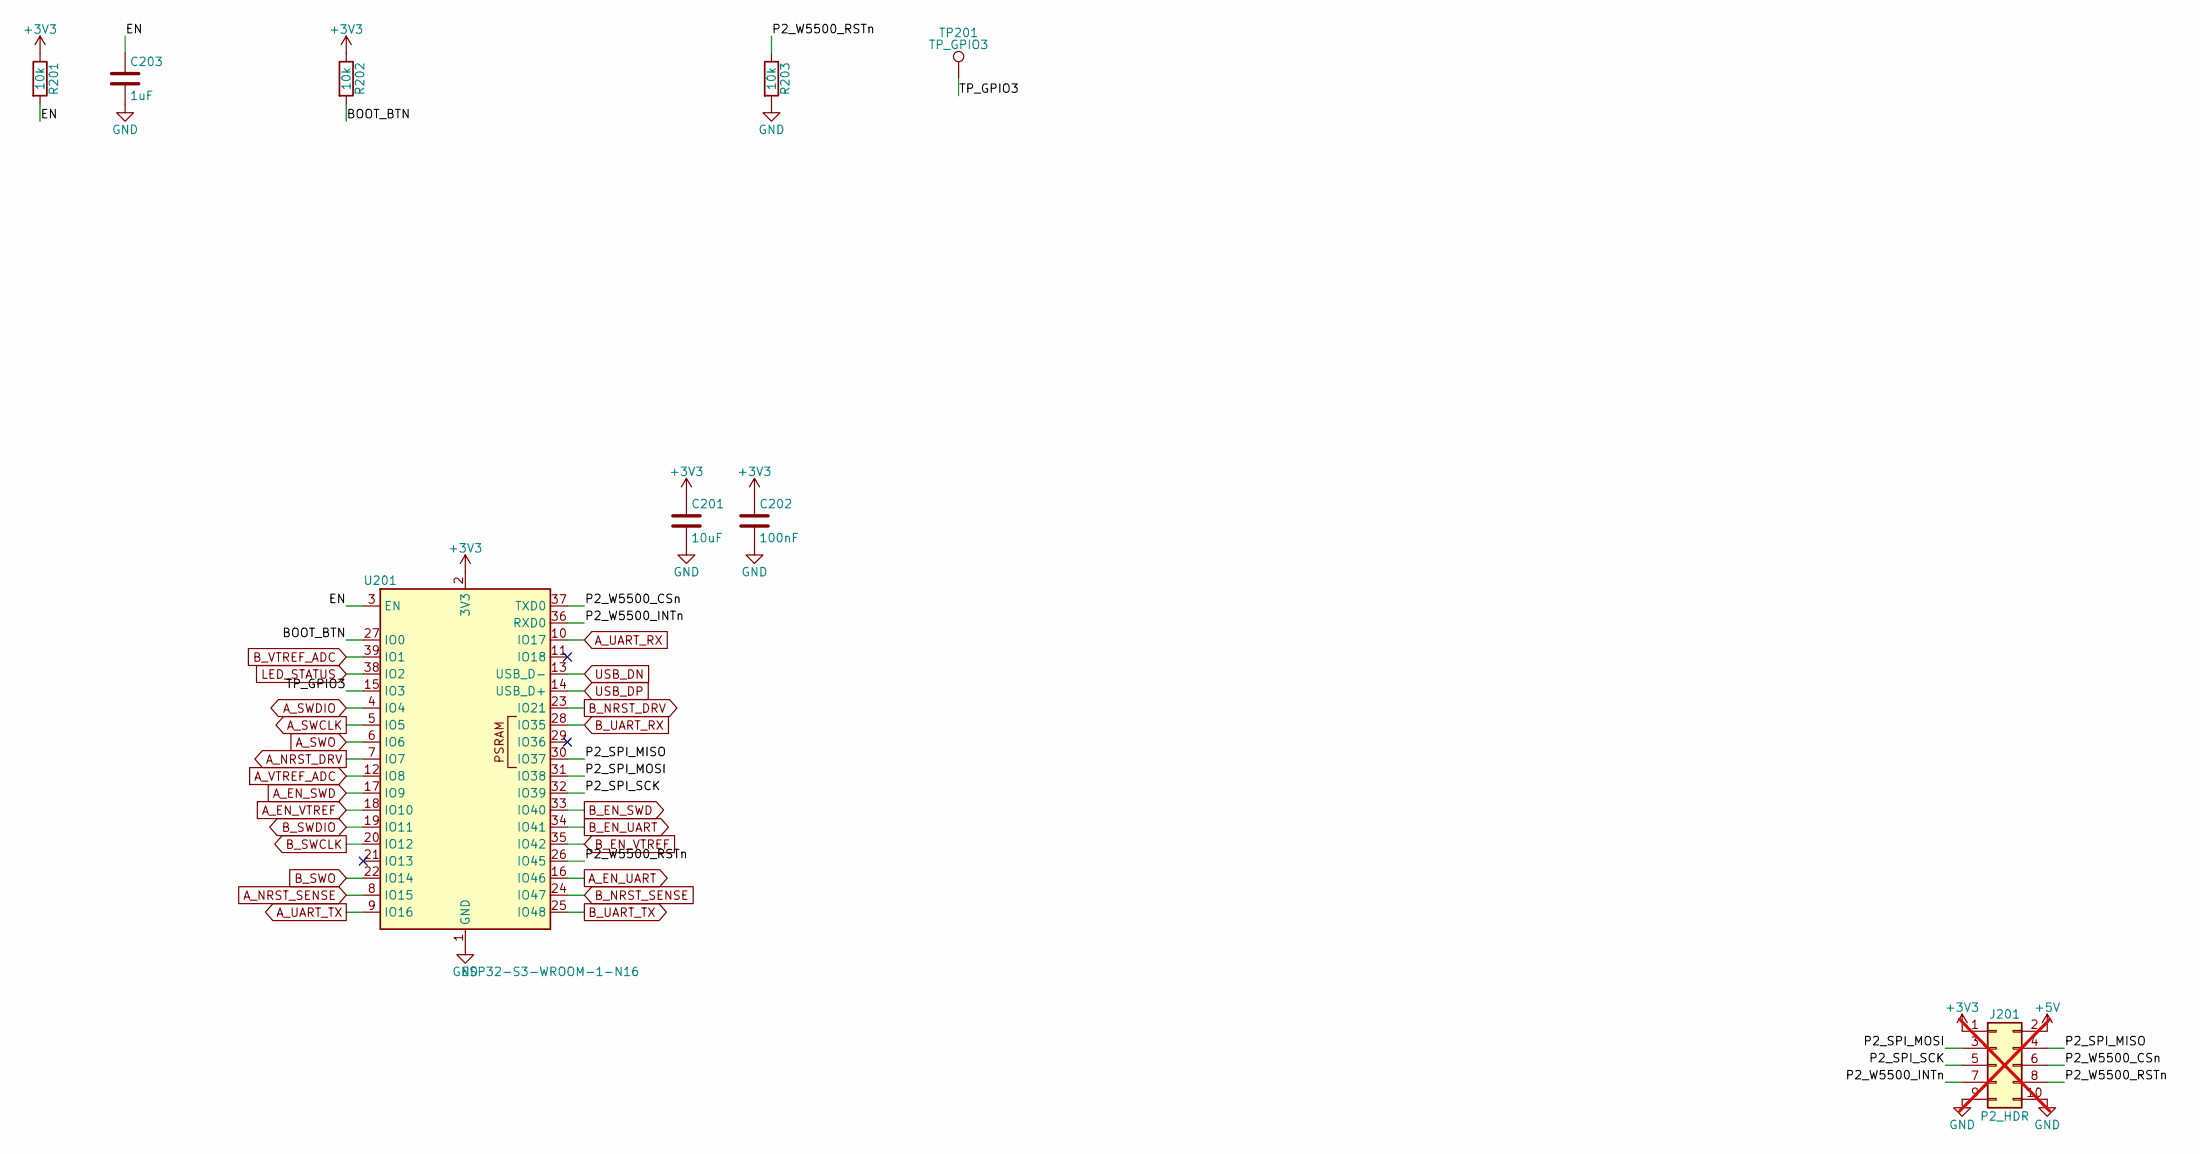
[picture p12: schematic mcu.kicad_sch]

Parts:
C201: 10uF; C_0805_2012Metric; LCSC C15850
C202: 100nF; C_0402_1005Metric; LCSC C1525
C203: 1uF; C_0402_1005Metric; LCSC C52923
J201: P2_HDR; PinHeader_2x05_P2.54mm_Vertical; not fitted
R201, R202, R203: 10k; R_0402_1005Metric; LCSC C25744
TP201: TP_GPIO3; TestPoint_Pad_D1.0mm
U201: ESP32-S3-WROOM-1-N16; ESP32-S3-WROOM-1; LCSC C2913199

Connections:
+3V3: C201.1, C202.1, J201.1, R201.1, R202.1, U201.2 (3V3); also elsewhere on the board
+5V: J201.2; also elsewhere on the board
/MCU/BOOT_BTN: R202.2, U201.27 (IO0)
/MCU/EN: C203.1, R201.2, U201.3 (EN)
/MCU/P2_SPI_MISO: J201.4, U201.30 (IO37)
/MCU/P2_SPI_MOSI: J201.3, U201.31 (IO38)
/MCU/P2_SPI_SCK: J201.5, U201.32 (IO39)
/MCU/P2_W5500_CSn: J201.6, U201.37 (TXD0)
/MCU/P2_W5500_INTn: J201.7, U201.36 (RXD0)
/MCU/P2_W5500_RSTn: J201.8, R203.1, U201.26 (IO45)
/MCU/TP_GPIO3: TP201.1 (1_1), U201.15 (IO3)
A_EN_SWD: U201.17 (IO9); also elsewhere on the board
A_EN_UART: U201.16 (IO46); also elsewhere on the board
A_EN_VTREF: U201.18 (IO10); also elsewhere on the board
A_NRST_DRV: U201.7 (IO7); also elsewhere on the board
A_NRST_SENSE: U201.8 (IO15); also elsewhere on the board
A_SWCLK: U201.5 (IO5); also elsewhere on the board
A_SWDIO: U201.4 (IO4); also elsewhere on the board
A_SWO: U201.6 (IO6); also elsewhere on the board
A_UART_RX: U201.10 (IO17); also elsewhere on the board
A_UART_TX: U201.9 (IO16); also elsewhere on the board
A_VTREF_ADC: U201.12 (IO8); also elsewhere on the board
B_EN_SWD: U201.33 (IO40); also elsewhere on the board
B_EN_UART: U201.34 (IO41); also elsewhere on the board
B_EN_VTREF: U201.35 (IO42); also elsewhere on the board
B_NRST_DRV: U201.23 (IO21); also elsewhere on the board
B_NRST_SENSE: U201.24 (IO47); also elsewhere on the board
B_SWCLK: U201.20 (IO12); also elsewhere on the board
B_SWDIO: U201.19 (IO11); also elsewhere on the board
B_SWO: U201.22 (IO14); also elsewhere on the board
B_UART_RX: U201.28 (IO35); also elsewhere on the board
B_UART_TX: U201.25 (IO48); also elsewhere on the board
B_VTREF_ADC: U201.39 (IO1); also elsewhere on the board
GND: C201.2, C202.2, C203.2, J201.9, J201.10, R203.2, U201.1 (GND), U201.40 (GND), U201.41 (GND); also elsewhere on the board
LED_STATUS: U201.38 (IO2); also elsewhere on the board
USB_DN: U201.13 (USB_D-); also elsewhere on the board
USB_DP: U201.14 (USB_D+); also elsewhere on the board

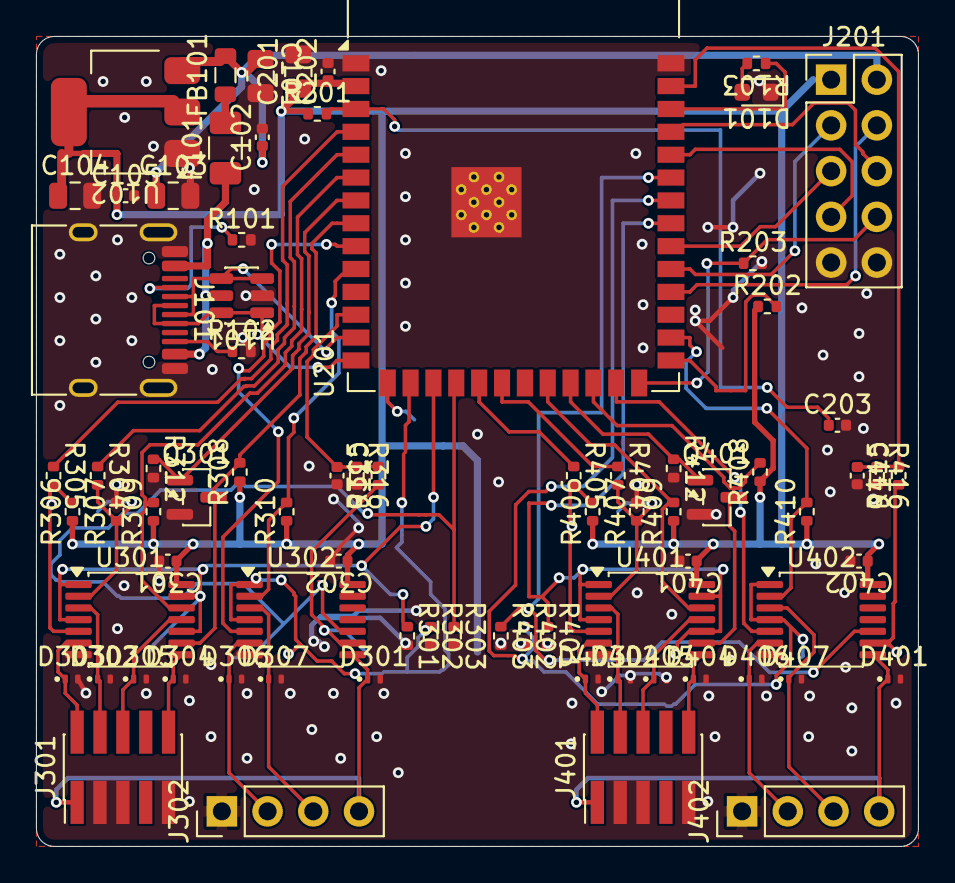
[picture p13: board dual_swd_flasher.kicad_pcb from above]

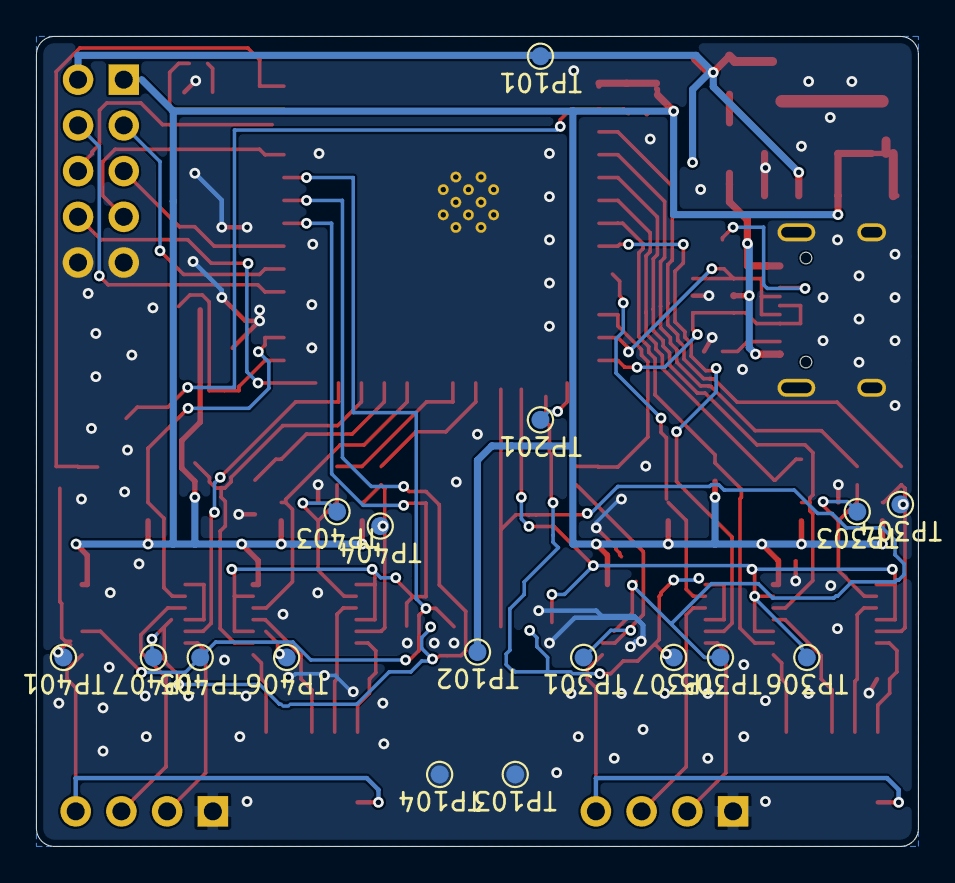
[picture p14: board dual_swd_flasher.kicad_pcb from below]

Board: 2 copper layers, 49.0 x 45.0 mm, 95 parts (17 on the bottom side), 62 nets.
