adihack/esp32-swd/(commit log)

2026-11-08 esp-swd: r5 hardware, firmware, portable library and host tools
    Initial public release under the MIT licence.
    - hardware/rev5: KiCad 10 project as built, schematic PDF, JLCPCB package
    - lib/: portable C11 SWD/ADIv5, Cortex-M control, generic RAM-loader
    runtime (call and streaming ABIs), on-target CRC-32 verify, target
    modules (nRF52), isolation interlock, framed host protocol
    - ports/esp32s3, boards/r5, app/: ESP-IDF firmware with the dedicated-GPIO
    SWD engine (8 MHz), crash-safe isolation, OTA partitions
    - host/python: esw client library and examples
    - tests/: bit-level SWD target simulator and 6 host test suites (CI)
    Measured on an nRF52840 DK: 1 MB erase + program + CRC verify in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
    [BOM-dual_swd_flasher.csv, BOM-dual_swd_flasher_JLCPCB.csv, channel_a.kicad_sch, channel_b.kicad_sch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]
2026-11-10 Target modules (nRF5340, STM32U5), parallel channels, UART DMA back-end
    SWD targets
    - nrf53: nRF5340 application and network core (attach core byte), page and
    fast whole-flash erase (NVMC ERASEALL with UICR restore, only when every KMU
    key slot is provably empty), firmware APPROTECT branch detected as locked,
    CTRL-AP ERASEALL recovery, one reset-halt before flash work (SPU locks).
    - stm32u5: STM32U575/585 and U59x/5Ax internal flash with TrustZone off:
    bank/page erase, quad-word runs and 128-byte burst programming paced by the
    AHB stall, ICACHE invalidate, watchdog freeze restored at detach, RDP 1 -> 0
    regression unlock with reconnect.
    - generic Cortex-M fallback (registered last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
    [build.py, client.py, esw_uart.c, esw_uart.h, flash_image.py, main.c, parallel_flash.py, proto.py]
2026-11-10 STM32U5 streaming flash loader, faster target clock, blank-skip flashing
    - loaders/stm32u5: resident streaming-ABI loader for the STM32U5 internal
    flash (Cortex-M33, position independent, 1.4 KB): 4 x 4 KB buffer ring,
    128-byte bursts with blank quad-words skipped, page/bank/chip erase with
    SWAP_BANK, CRC-32. build.py compiles it and plays the probe's side against
    a model of the FLASH registers in unicorn before writing the .inc.
    - stm32u5 module: flash region served by the loader (ESW_U5_DIRECT keeps the
    probe-driven path); loader_prepare reset-halts once and raises the core to
    MSIS 48 MHz (range 1, 4 wait states) on a clean part.
    - loader runtime: stream_program returns once th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
    [build.py, client.py, main.c, test_loader.c]
2026-11-11 MVP: esw CLI and daemon (TTY bridge, shared access), switch modes, fw 0.5.0
    Firmware 0.5.0, protocol 5:
    - CH_MODE (0x13): per switch group auto / on (host pin holder) / off (inhibit,
    survives host loss). The VTref interlock applies in every mode. UART modes
    run on the dispatcher, SWD modes on the channel's worker.
    - CH_STATE reports modes, UART stream state and the SWD session.
    - ESW_UART_LOOPBACK: TX looped to RX inside the UART, pads untouched; a
    self-test of both UARTs without a DUT.
    - INFO reports a boot id (RTC counter + RNG), so hosts see every restart:
    USB-Serial-JTAG does not re-enumerate on esp_restart().
    Host (host/python, pip install -e host/python):
    - esw CLI: info, flas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
2026-11-11 Handover docs: status, testing guide, new-machine setup
    - docs/status.md: what exists (MVP table with evidence), decisions (stay on
    USB-Serial-JTAG, board-enforced isolation, ownership, DUT firmware rules),
    known limitations and risks, next steps, history.
    - docs/testing.md: software tests, then every hardware test grouped by bench
    (board only; nRF5340 + STM32U585 with cross-cabled UARTs; nRF52840 DK) with
    wiring, command and the last measured result.
    - README: "New machine" setup from a fresh clone; pointers to the new pages.
    - CLAUDE.md: session start pointers; machine setup and gotchas without
    PC-specific paths; bench state as of 2026-11-11; version bump rules.
    - robustness_chec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
2026-11-11 Docs: DUT console wiring and test; drop DUT backup references
    - CLAUDE.md, docs/testing.md: the UART headers are wired to the DUTs' Zephyr
    consoles (115200 8N1); cross-cabling stays as the throughput-test setup.
    New test: console capture after esw reset (nRF5340 12.4 KB, STM32 9.7 KB of
    boot log, 0 framing errors). Swapped TX/RX shows as 0 bytes and 0 errors.
    - hardware-reference.md: console result in section 12.
    - Remove references to DUT firmware backups; the DUT rule is now "ask before
    writing".
